sinoagg/RiskChemi/RiskChemi_vMP/RiskChemi_Monitor_V1.04M1_Common Installation/RiskChemi_Monitor_V1.04M1.xlsx

Comment | Description | Designator | Footprint | LibRef | Quantity
BUZZER | Buzzer | BUZ1 | BUZ0905 | BUZZER | 1
100nF | Capacitor | C1, C2, C3, C4, C21, C26 | 0603 | Cap | 6
1uF | Capacitor | C5, C11 | 0603 | Cap | 2
0.8pF | Inductor | C6 | 0402 | Inductor | 1
100nF | Capacitor,100V | C7 | 0805 | Cap | 1
22uF | Capacitor, Capacitor,50V, Capacitor | C8, C15, C22 | 0805 | Cap | 3
22nF | Capacitor | C10 | 0603 | Cap | 1
330pF | Capacitor | C16 | 0402 | Cap | 1
1uF | Capacitor,100V | C17 | 0805 | Cap | 1
100nF | Capacitor | C19 | 0402 | Cap | 1
18pF | Capacitor | C23, C24 | 0402 | Cap | 2
470pF | Capacitor | C25 | 0402 | Cap | 1
1.8pF | Capacitor | C27 | nosilk_0402 | Cap | 1
10uF | Polarized Capacitor (Radial) | C59 | 6032_pol | Cap Pol1 | 1
Header 4 | Header, 4-Pin | CAN, POWER_24V | C3000VS | Header 4 | 2
B290-13-F | Default Diode | D1 | B290 | Diode | 1
LED0 | green LED | D3 | LED | LED0 | 1
PESD2CAN |  | D4 | SOT23 | PESD1CAN | 1
VS-3EJH02HM3/6A | 1 Amp General Purpose Rectifier | D5 | B290 | Diode 1N4007 | 1
SM8S33 | 1 Amp General Purpose Rectifier | D6 | SM8S | Diode 1N4007 | 1
USB Connector |  | DLOAD | Mini_USB | Component_1 | 1
NULL | Inductor | L1 | 0402 | Inductor | 1
3.9nH | Inductor | L2 | 0603 | Inductor | 1
15uH | Inductor, 1A | L3 | 4*4 Inductor | Inductor | 1
2N7002 |  | Q1 | 2N7002 | N-MOSFET | 1
100 | Resistor | R1 | 0603 | Res1 | 1
10K | Resistor | R2 | 0603 | Res1 | 1
210K | Resistor | R6 | 0402 | Res1 | 1
40.2K | Resistor | R7 | 0402 | Res1 | 1
47.5K | Resistor | R8 | 0402 | Res1 | 1
200K | Resistor | R9 | 0402 | Res1 | 1
2.2K | Resistor | R32 | 0603 | Res1 | 1
ACM7060-301-2PL-TL01 | Transformer (Equivalent Circuit Model) | T1 | ACM7060-301-2P-TL01 | Trans Eq | 1
ACT45B-510-2P | Transformer (Equivalent Circuit Model) | T2 | ACT45B-510-2P | Trans Eq | 1
TFT | Header, 12-Pin | TFT_USART | FCC_10pin_1mm | Header 12 | 1
STM32F103C8T6 | ARM Cortex-M3 32-bit MCU, 64 KB Flash, 20 KB Internal RAM, 37 I/Os, 48-pin LQFP, -40 to 85 degC, Tray | U1 | STM-LQFP48_M | STM32F103C8T6 | 1
RT9193 |  | U3 | SOT-23-5 | RT9193 | 1
MP2565 | DCDC 4.5V~28V input 1.8V ~5V output low power | U4 | SO8 | MP1584 | 1
TJA1050T | CAN Tranceiver | U6 | SO8 | TJA1050T | 1
CMT2219A |  | U7 | QFN16 | CMT2219A | 1
8M smd |  | X1 | 8Mhz_XTAL | 8M smd | 1
XTAL_TSX3225_26M |  | X2 | XTAL3225 | XTAL_Negative | 1
