sinoagg/RiskChemi/RiskChemi_vMP/RiskChemi_Sensors_V2.04M1_Common Installation/RiskChemi_Sensors_V2.04M1.xlsx

Comment | Description | Designator | Footprint | LibRef | Quantity
Antenna | Generic Antenna | Ant. | PIN1 | Antenna | 1
BUZZER 0905 through hole | Buzzer | BUZ1 | BUZ0905 | BUZZER | 1
10uF | Capacitor,50V, Capacitor, Capacitor, Capacitor, Capacitor | C1, C33, C48, C55, C56 | 0805 | Cap | 5
100nF | Capacitor | C2, C3, C4, C5, C6, C8, C11, C12, C13, C19, C31, C32, C36, C46 | 0603 | Cap | 14
1uF | Capacitor | C7, C27, C30 | 0603 | Cap | 3
2.2pF | Inductor | C9 | 0603C | Inductor | 1
100nF | Capacitor | C14, C40, C44 | 0402 | Cap | 3
82pF | Capacitor | C15 | 0402 | Cap | 1
NULL | Capacitor | C16, C21 | 0402 | Cap | 2
22uF | Capacitor,50V | C17 | 0805 | Cap | 1
150pF | Capacitor | C18 | 0603 | Cap | 1
1uF | Capacitor | C22, C42 | 0402 | Cap | 2
22uF | Capacitor | C39 | 1206 | Cap | 1
22nF | Capacitor | C41 | 0402 | Cap | 1
47uF | Polarized Capacitor (Radial) | C52 | cap_pol_8*10.2 | Cap Pol1 | 1
LED | Typical INFRARED GaAs LED | D1 | 1206_LED | LED0 | 1
B290-13-F | Default Diode | D2 | B290 | Diode | 1
1N4007 | 1 Amp General Purpose Rectifier | D4 | 6032_pol | Diode 1N4007 | 1
SMAJ36CA | 1 Amp General Purpose Rectifier | D6 | B290 | Diode 1N4007 | 1
LED_POWER | Typical INFRARED GaAs LED | D7 | 1206_LED | LED0 | 1
USB Connector |  | DLOAD | Mini_USB | Component_1 | 1
Header 2 | Header, 2-Pin | FAN, Power | HDR1X2 | Header 2 | 2
100nH | Inductor | L1 | 0603C | Inductor | 1
27nH | Capacitor | L2 | 0402 | Cap | 1
15uH | Inductor, 1A | L3 | 4*4 Inductor | Inductor | 1
22uH | Inductor, 1A | L4 | 10*10Inductor | Inductor | 1
10uH | Inductor | L6 | 0805 | Inductor | 1
2N7002 |  | Q1 | 2N7002 | N-MOSFET | 1
100R | Resistor | R1 | 0603 | Res1 | 1
10K | Resistor | R2, R30 | 0603 | Res1 | 2
0R | Inductor | R3 | 0603C | Inductor | 1
510R | Resistor | R9, R40 | 0603 | Res1 | 2
1M | Resistor | R10, R11, R12 | 0603 | Res1 | 3
200K | Resistor | R15 | 0603C | Res1 | 1
100k | Resistor | R18, R29 | 0603 | Res1 | 2
200K | Resistor | R19 | 0402 | Res1 | 1
205K | Resistor | R20 | 0603 | Res1 | 1
40.2K | Resistor | R21 | 0603 | Res1 | 1
5.1K | Resistor | R25, R27 | 0603 | Res1 | 2
3362P_2K_adj_res |  | R26 | res_adj | res_adj | 1
1K | Resistor | R28 | 0603 | Res1 | 1
HRO韩国韩荣拨码开关 |  | SW1 | SW_6P_HRO | SW_6P | 1
STM32F103RBT6 | STM32 ARM-based 32-bit MCU with 64 Kbytes Flash, 64-pin LQFP, Industrial Temperature | U1 | LQFP64_N | STM32F103R8T6 | 1
RT9013-33GB |  | U2 | SOT-23-5 | RT9193 | 1
MP2565DN | DCDC 4.5V~28V input 1.8V ~5V output low power | U4 | so-8 | MP1584 | 1
CMT2119A |  | U5 | SOT23-6 | CMT2119A | 1
TGS2602 | VOC sensor | U6 | Gas Sensor TGS2602 Slot | TGS2602 | 1
LMV321SQ3T2G |  | U7, U10, U12 | SC-70-5 | LMV321SQ3T2G | 3
SHT20 |  | U8 | SHT20 | SHT20 | 1
Gas Sensor 2M010 |  | U9 | Gas Sensor 2M010 Slot | Gas Sensor | 1
WS101 |  | U11 | Gas_Sensor_WS101_Slot | Gas Sensor_WS101 | 1
RT9193-30GB |  | U13 | SOT-23-5 | RT9193 | 1
8M smd |  | X1 | 8Mhz_XTAL | 8M smd | 1
XTAL_Negative |  | X2 | XTAL3225 | XTAL_Negative | 1
