sinoagg/RiskChemi/(list of files, drawings)

Other design files:
RiskChemi_Monitor_V1.03/RiskChemi_Monitor_V1.03.PcbDoc
RiskChemi_Monitor_V1.03/RiskChemi_Monitor_V1.03.PrjPcb
RiskChemi_Monitor_V1.03/RiskChemi_Monitor_V1.03.SchDoc
RiskChemi_Monitor_V1.04/RiskChemi_Monitor_V1.04.PcbDoc
RiskChemi_Monitor_V1.04/RiskChemi_Monitor_V1.04.PrjPcb
RiskChemi_Monitor_V1.04/RiskChemi_Monitor_V1.04.SchDoc
RiskChemi_Sensors_V2.02/RiskChemi_Sensors.PcbDoc
RiskChemi_Sensors_V2.02/RiskChemi_Sensors.PrjPcb
RiskChemi_Sensors_V2.02/RiskChemi_Sensors.SchDoc
RiskChemi_Sensors_V2.03/RiskChemi_Sensors_V2.03.PcbDoc
RiskChemi_Sensors_V2.03/RiskChemi_Sensors_V2.03.PrjPcb
RiskChemi_Sensors_V2.03/RiskChemi_Sensors_V2.03.SchDoc
RiskChemi_Sensors_V2.04/RiskChemi_Sensors_V2.04.PcbDoc
RiskChemi_Sensors_V2.04/RiskChemi_Sensors_V2.04.PrjPcb
RiskChemi_Sensors_V2.04/RiskChemi_Sensors_V2.04.SchDoc
RiskChemi_vMP/RiskChemi_Monitor_V1.04M1_Common Installation/RiskChemi_Monitor_V1.04M1.PcbDoc
RiskChemi_vMP/RiskChemi_Monitor_V1.04M1_Common Installation/RiskChemi_Monitor_V1.04M1.PrjPcb
RiskChemi_vMP/RiskChemi_Monitor_V1.04M1_Common Installation/RiskChemi_Monitor_V1.04M1.SchDoc
RiskChemi_vMP/RiskChemi_Sensors_V2.04M1_Common Installation/RiskChemi_Sensors_V2.04M1.PcbDoc
RiskChemi_vMP/RiskChemi_Sensors_V2.04M1_Common Installation/RiskChemi_Sensors_V2.04M1.PrjPcb
RiskChemi_vMP/RiskChemi_Sensors_V2.04M1_Common Installation/RiskChemi_Sensors_V2.04M1.SchDoc
RiskChemi_vMP/RiskChemi_Sensors_V2.04M2_Metal Proximity Installation/RiskChemi_Sensors_V2.04M2.PcbDoc
RiskChemi_vMP/RiskChemi_Sensors_V2.04M2_Metal Proximity Installation/RiskChemi_Sensors_V2.04M2.PrjPcb
RiskChemi_vMP/RiskChemi_Sensors_V2.04M2_Metal Proximity Installation/RiskChemi_Sensors_V2.04M2.SchDoc
RiskChemi_vMP/危化测试仪_生产提交文件/硬件/PCB加工文件/RiskChemi_Monitor_V1.04M1_Common Installation/PCB生产文件/RiskChemi_Monitor_V1.04M1.PcbDoc
RiskChemi_vMP/危化测试仪_生产提交文件/硬件/PCB加工文件/RiskChemi_Sensors_V2.04M1_Common Installation/PCB生产文件/RiskChemi_Sensors_V2.04M1.PcbDoc
RiskChemi_vMP/危化测试仪_生产提交文件/硬件/PCB加工文件/RiskChemi_Sensors_V2.04M2_Metal Proximity Installation/PCB生产文件/RiskChemi_Sensors_V2.04M2.PcbDoc
RiskChemi_vMP/危化测试仪_生产提交文件/硬件/电路图/RiskChemi_Monitor_V1.04M1_Common Installation/RiskChemi_Monitor_V1.04M1.SchDoc
RiskChemi_vMP/危化测试仪_生产提交文件/硬件/电路图/RiskChemi_Sensors_V2.04M1_Common Installation/RiskChemi_Sensors_V2.04M1.SchDoc
RiskChemi_vMP/危化测试仪_生产提交文件/硬件/电路图/RiskChemi_Sensors_V2.04M2_Metal Proximity Installation/RiskChemi_Sensors_V2.04M2.SchDoc
