sinoagg/RiskChemi/RiskChemi_vMP/RiskChemi_Monitor_V1.04M1_Common Installation/Monitor_V1.04M1 update info.txt

v1.04M1修改内容

1. 调整产品名称，版本号，修改日期的丝印；
2. 修改L1(6.8nH)为L1(NULL);
3. 修改C27(2.7pF)为C27(1.8pF);
4. 修改Ln(6.8nH)为C6(0.8pF);
