sinoagg/RiskChemi/RiskChemi_vMP/RiskChemi_Sensors_V2.04M1_Common Installation/Sensor_V2.04M1 update info.txt

v2.04M1修改内容

1. 此版本为适用于常规安装方式的版本，即设配固定在金属抱杆（扶手）上，正反面1cm以内无大面积金属；
2. 调整5V电源线的位置，使其到24V_PowerIn之间的距离增大，并调整相应的接地过孔；
3. 修改C10(NULL)为L2(27nH);
4. 修改L5(0R)为C9(2.2pF);
5. 修改C16(3.9pF)为C16(NULL);
6. 修改L2(8.2nH)为R3(0R);
