sinoagg/RiskChemi/RiskChemi_vMP/RiskChemi_Sensors_V2.04M2_Metal Proximity Installation/Sensor_V2.04M2 update info.txt

v2.04M2修改内容（Based on v2.04）

1. 此版本为适用于设备正反面1CM内有大面积金属（如投币箱）的安装情形；
2. 调整5V电源线的位置，使其到24V_PowerIn之间的距离增大，并调整相应的接地过孔；
3. 修改C10(NULL)为L2(NULL);
4. 修改L5(0R)为C9(0.8pF);
5. 修改C16(3.9pF)为L5(27nH);
6. 修改L2(8.2nH)为C10(2.2pF);
