sinoagg/RiskChemi/RiskChemi_Sensors_V2.04/Sensor_V2.04 update info.txt

v2.04修改内容

1. 按照市场部门要求，保留风扇接口，并移回V2.01中的位置；
2. 修改天线封装，将SMA接头改为单端口接头；
3. 天线接口位置下移；
4. PCB左侧留净空，以适配无风扇版本的外壳；
5. 移动X1/C30/L4/POWER的位置；
6. 上下翻转R18和FAN接口；
7. 后续生产时需要调换FAN CABLE两根线的位置；
