sinoagg/RiskChemi/RiskChemi_Monitor_V1.04/Monitor_V1.04 update info.txt

v1.04修改内容

1. 增加天线净空区域面积；
2. 将天线形式修改为PCB天线；
