sinoagg/RiskChemi/RiskChemi_Sensors_V2.02/RiskChemi_Sensors.PcbDoc.htm

Reporting Options

# File in Newer Format

Date | : | 2018/4/24
Time | : | 13:40:30
Filename | : | D:\Project\RiskChemi_Sensors_V2\RiskChemi_Sensors_V2.01\RiskChemi_Sensors.PcbDoc

Version | Warning
Release 15 | CAUTION - Support of separate solder masks for top & bottom of pads added.
Release 15.1 | CAUTION - Support Multi-line PCB Text added.
Release 16.0 | CAUTION - Pad/Via hole size tolerance value added.

This file was generated by a later version of the software
