sinoagg/RiskChemi/RiskChemi_Sensors_V2.02/ReadMe.txt

RiskChemi_Sensors

Version：2.01
说明：
1.修改2M010传感器加热地线端导线过细错误。
2.增加传感器加热端电容容量，防止因为传感器加热电流变化对总线电压带来的影响。
3.使用RT9013替换RT9193，增加电流输出。
4.增加板载蜂鸣器。
5.将原有的0R单片机模拟供电电阻替换为10uH电感，减少数字部分对模拟采集带来的干扰。
6.减少DIO输出接口，直接控制蜂鸣器。

Version：2.00
说明：
请参考Word文档。

Version:1.06

说明：
1.调整WS MC101传感器引脚焊盘
2.增加电源指示灯
3.增加调零指示灯
4.增加灵敏度调节拨码开关

Version: 1.05

说明：
1.适配炜盛MC101传感器

Version: 1.04

说明：
1.将弹簧天线改成SMA连接器天线以适配金属外壳
2.增加4个连接端子以适配汽油传感器（只需要两个端子）或其他类型的传感器使用
3.板子上增加2M010汽油传感器的驱动
