sinoagg/RiskChemi/RiskChemi_Sensors_V2.03/Sensor_V2.03 update info.txt

v2.03修改内容

1. 修改24V电源接口封装并调整位置；
2. 去掉RS485接口到MCU之间的电路；
3. L4逆时针方向旋转90deg；
4. 调整24V电源线的走线方式；
