sinoagg/RiskChemi/(commit log)

2018-05-21 file push
    [RiskChemi_Monitor_V1.03.PcbDoc, RiskChemi_Monitor_V1.03.PrjPcb, RiskChemi_Monitor_V1.03.SchDoc, RiskChemi_Sensors_V2.03.PcbDoc, RiskChemi_Sensors_V2.03.PrjPcb, RiskChemi_Sensors_V2.03.SchDoc]
2018-05-21 add former version of v2.02
    [RiskChemi_Sensors.PcbDoc, RiskChemi_Sensors.PrjPcb, RiskChemi_Sensors.SchDoc]
2018-05-21 PreView files
    [RiskChemi_Sensors_V2.03.PcbDoc]
2018-05-28 New version of Sensor_V2.04
    [RiskChemi_Sensors_V2.04.PcbDoc, RiskChemi_Sensors_V2.04.PrjPcb, RiskChemi_Sensors_V2.04.SchDoc]
2018-05-31 Sensor v_2.04 modified
    [RiskChemi_Monitor_V1.04.PcbDoc, RiskChemi_Monitor_V1.04.PrjPcb, RiskChemi_Monitor_V1.04.SchDoc, RiskChemi_Sensors_V2.04.PcbDoc, RiskChemi_Sensors_V2.04.SchDoc]
2018-07-06 commit files for Mass-Production(MP)
    [RiskChemi_Monitor_V1.04M1.PcbDoc, RiskChemi_Monitor_V1.04M1.PrjPcb, RiskChemi_Monitor_V1.04M1.SchDoc, RiskChemi_Monitor_V1.04M1.xlsx, RiskChemi_Sensors_V2.04M1.PcbDoc, RiskChemi_Sensors_V2.04M1.PrjPcb, RiskChemi_Sensors_V2.04M1.SchDoc, RiskChemi_Sensors_V2.04M1.xlsx]
